stack07142/2012-Intelligent-Model-Car-Contest/img/2012_mie_pic.jpg

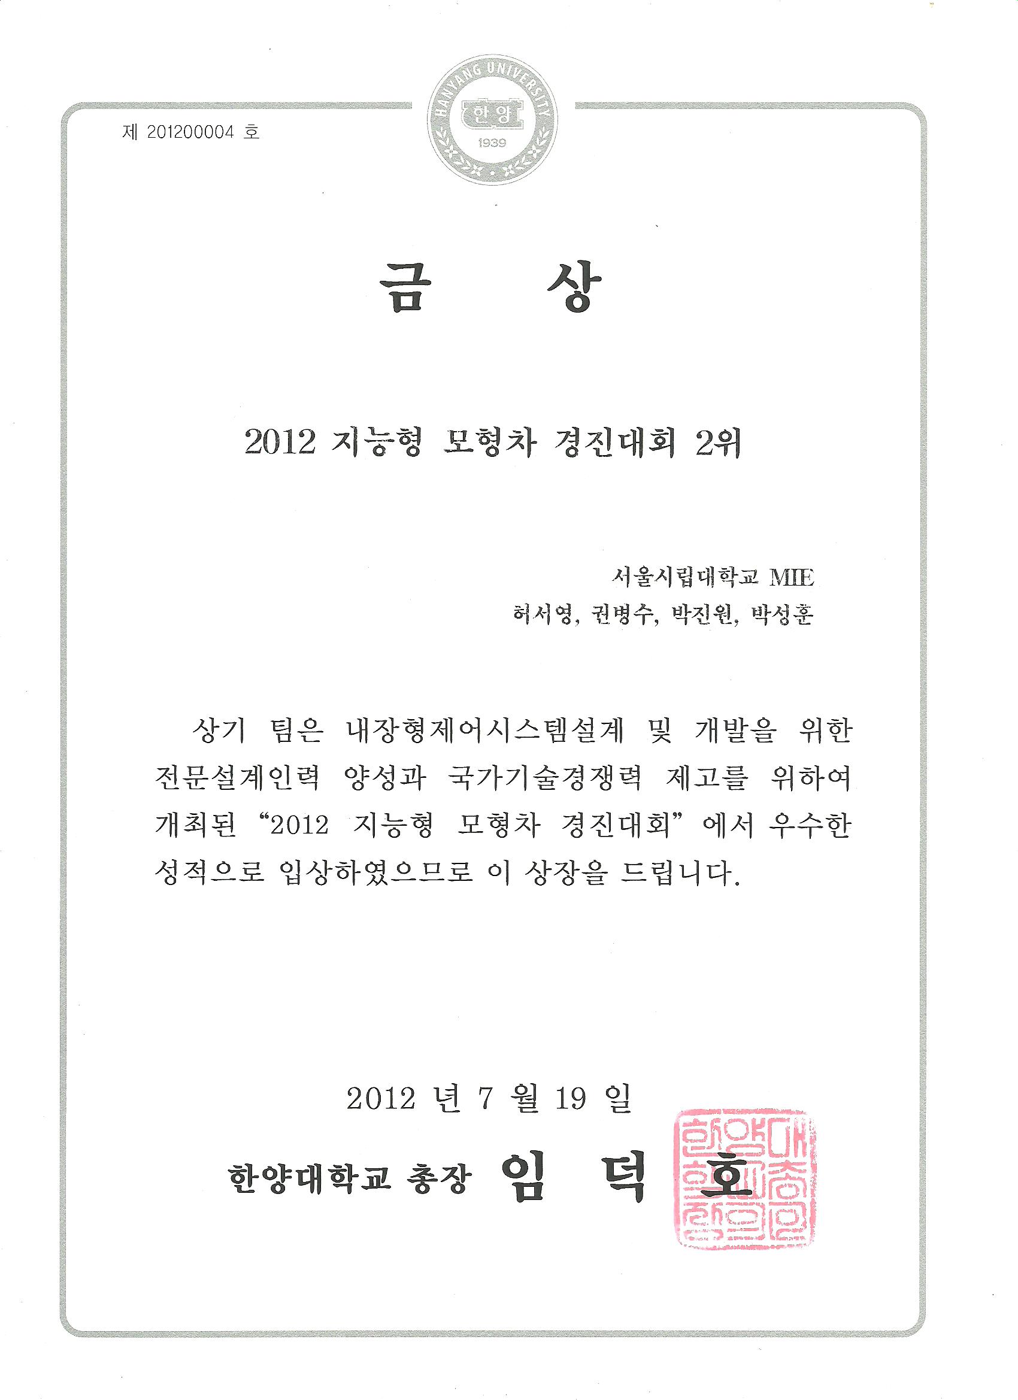
img/2012_mie_pic.jpg
